minteyay/gkos_pebble/README.md

# wireless GKOS chording keyboard + mouse with BLE

based on the GKOS chording standard (http://gkos.com/gkos/gkos-charset.html) with a few modifications for computer-centric usage.
