minteyay/gkos_pebble/gkos_pebble_BOM.xlsx

Reference | Value | Footprint | Qty | €/unit | subtot. | source
BAT1,BAT2 | Keystone 55 | Keystone 55 | 2 | 0.370 | 0.740 | https://www.digikey.fi/en/products/detail/keystone-electronics/55/316403
C2-C5 | 10uF | 0603 | 4 |  | 0.000
C6,C7 | 15pF | 0402 | 2 |  | 0.000
C8,C23 | 100nF | 0603 | 2 |  | 0.000
C9,C10,C12,C14-C20 | 100nF | 0402 | 10 |  | 0.000
C11,C13 | 1uF | 0402 | 2 |  | 0.000
C21,C22 | 12pF | 0603 | 2 |  | 0.000
C24 | 4.7uF | 0603 | 1 |  | 0.000
C25-C34,C39 | 0.1uF | 0603 | 11 |  | 0.000
C35-C38 | 1uF | 0603 | 4 |  | 0.000
D1 | UDT14A05L03 | SOT-143 | 1 | 0.330 | 0.330 | https://www.digikey.fi/en/products/detail/yageo/UDT14A05L03/10126659
D2-D4 | LAD52C03L01 | SOD-523 | 3 | 0.196 | 0.588 | https://www.digikey.fi/en/products/detail/yageo/LAD52C03L01/15855310
D5-D8 | RB521S30 | SOD-523 | 4 | 0.102 | 0.408 | https://www.digikey.fi/en/products/detail/onsemi/RB521S30T1G/964627
D9 | IN-S63AT5A | 0603 LED | 1 | 0.163 | 0.163 | https://www.digikey.fi/en/products/detail/inolux/IN-S63AT5A/7604928
F1 | 0ZCJ0005FF2E | 1206 | 1 | 0.142 | 0.142 | https://www.digikey.fi/en/products/detail/bel-fuse-inc/0ZCJ0005FF2E/4156127
IC1 | RT8096AHGJ5 | SOT-23-5 | 1 | 0.370 | 0.370 | https://www.digikey.fi/en/products/detail/richtek-usa-inc/RT8096AHGJ5/5820077
IC2 | TLV61070A | SOT-23-6 | 1 | 0.450 | 0.450 | https://www.digikey.fi/en/products/detail/texas-instruments/TLV61070ADBVR/16982069
IC3 | W25Q64JVZPIQ | WSON-8 | 1 | 1.020 | 1.020 | https://www.digikey.fi/en/products/detail/winbond-electronics/W25Q64JVZPIQ/15181953
IC4 | RP2040 | QFN-56 | 1 | 0.650 | 0.650 | https://www.digikey.fi/en/products/detail/raspberry-pi/SC0914-13/14306010
IC5 | AT24C01D-STUM-T | SOT-23-5 | 1 | 0.150 | 0.150 | https://www.digikey.fi/en/products/detail/microchip-technology/AT24C01D-STUM-T/4914368
J1 | 20021121-00006T4LF | hdr 2x03 P1.27mm vert | 1 | 0.560 | 0.560 | https://www.digikey.fi/en/products/detail/amphenol-cs-fci/20021121-00006T4LF/4243603
J2 | 217183-0001 | 217183-0001 | 1 | 1.150 | 1.150 | https://www.digikey.fi/en/products/detail/molex/2171830001/13913751?s=N4IgTCBcDa4IwHY4A4DMBaADNuIC6AvkA
J3 | BM03B-SRSS-TB | JST SH BM03B-SRSS-TB | 1 | 0.490 | 0.490 | https://www.digikey.fi/en/products/detail/jst-sales-america-inc/BM03B-SRSS-TB/926695
J4 | TPS43 (connection) | bare wires to MOD2 | 1 | 0.000 | 0.000
J5 | F3311A7H121010E200 | F3311A7H121010E200 | 1 | 0.420 | 0.420 | https://www.digikey.fi/en/products/detail/amphenol-cs-fci/F3311A7H121010E200/15287509
L1 | 1.5uH | 1008 | 1 | 0.260 | 0.260 | https://www.digikey.fi/en/products/detail/murata-electronics/DFE252012P-1R5M-P2/5247259
L2 | 2.2uH | EXL1V0402-2R2-R | 1 | 0.680 | 0.680 | https://www.digikey.fi/en/products/detail/eaton-electronics-division/EXL1V0402-2R2-R/13912348
LCD1 | LS013B7DH03 | LS013B7DH03 | 1 | 11.000 | 11.000 | https://www.digikey.fi/en/products/detail/sharp-microelectronics/LS013B7DH03/5300387
MOD1 | BT832A | BT832A | 1 | 6.510 | 6.510 | https://www.digikey.fi/en/products/detail/fanstel-corp/BT832A/8323654
MOD2 | TPS43-201A-S | TPS43 | 1 | 4.280 | 4.280 | https://www.digikey.fi/en/products/detail/azoteq-pty-ltd/TPS43-201A-S/7164940
Q1 | SSM3J35AMFV | SOT-723 | 1 | 0.220 | 0.220 | https://www.digikey.fi/en/products/detail/toshiba-semiconductor-and-storage/SSM3J35AMFV-L3F/8543433
R1,R2 | 5.1k | 0603 | 2 |  | 0.000
R3,R5 | 100k 1% | 0603 | 2 |  | 0.000
R4 | 22k 1% | 0603 | 1 |  | 0.000
R6 | 18k 1% | 0603 | 1 |  | 0.000
R7 | 1k | 0603 | 1 |  | 0.000
R9 | 1k | 0402 | 1 |  | 0.000
R10,R11 | 27.4 | 0402 | 2 |  | 0.000
R12,R13 | 100R | 0402 | 2 |  | 0.000
R14,R15 | 10k | 0402 | 2 |  | 0.000
R16 | 560R | 0603 | 1 |  | 0.000
R17-R22,R29-R32,R37-R39 | 100k | 0603 | 13 |  | 0.000
R23-R28,R33-R36,R40-R42 | 10k | 0603 | 13 |  | 0.000
SW1-SW6 | D2LS-21 | D2LS | 6 | 1.578 | 9.468 | https://www.digikey.fi/en/products/detail/omron-electronics-inc-emc-div/D2LS-21/5031942
SW7-SW10 | EVQ-Q2H03W | EVQ-Q2H03W | 4 | 0.235 | 0.940 | https://www.digikey.fi/en/products/detail/panasonic-electronic-components/EVQ-Q2H03W/762890
SW11-SW13 | RKB2SJM250SMTR | RKB2SJM250SMTRLFS | 3 | 0.180 | 0.540 | https://www.digikey.fi/en/products/detail/c-k/RKB2SJM250SMTR-LFS/13997207
Y1 | RH100-12.000-12-1010-X-TR-NS2 | RH100 | 1 | 0.170 | 0.170 | https://www.digikey.fi/en/products/detail/raltron-electronics/RH100-12-000-12-1010-X-TR-NS2/15963328
Y2 | FC-135 32.7680KA-AC0 | 3215 XTAL | 1 | 0.560 | 0.560 | https://www.digikey.fi/en/products/detail/epson/FC-135-32-7680KA-AC0/2834057
 |  | subtotal excl. VAT |  |  | 42.259
 |  | total incl. 24% VAT |  |  | 52.401
