minteyay/gkos_pebble/gkos_pebble.kicad_pcb

## KiCad design gkos_pebble.kicad_pcb (2024-04-06)

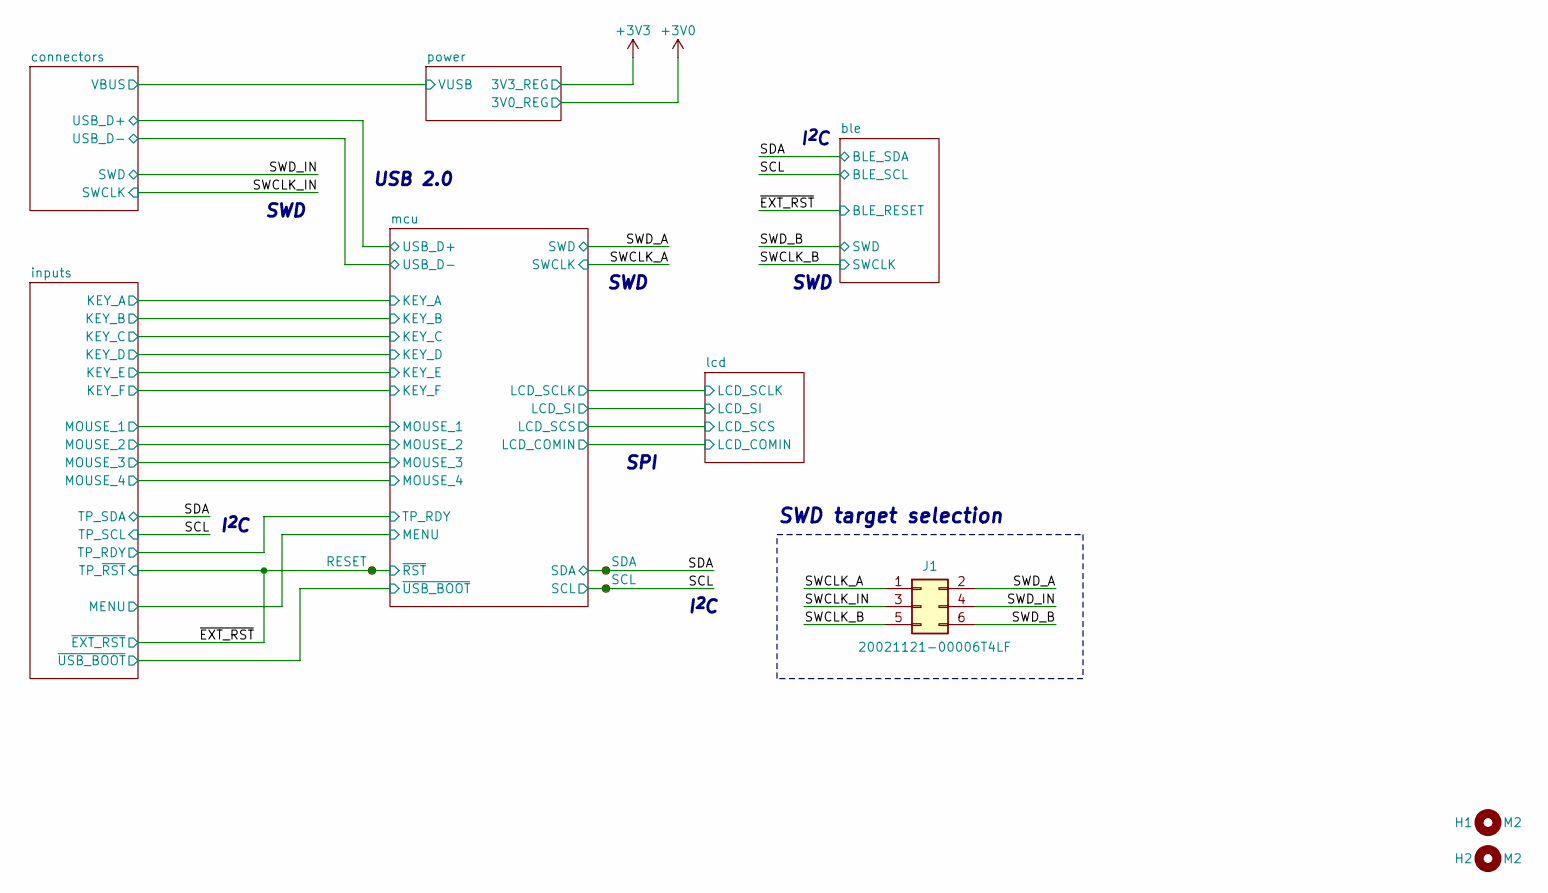
[picture p8: schematic gkos_pebble.kicad_sch, gkos pebble]

Parts:
H1, H2: M2; MountingHole_2.2mm_M2
J1: 20021121-00006T4LF; PinHeader_2x03_P1.27mm_Vertical_SMD
TP1: RESET; TestPoint_Pad_D1.0mm
TP2: SDA; TestPoint_Pad_D1.0mm
TP3: SCL; TestPoint_Pad_D1.0mm

Connections:
/SCL: TP3.1; also elsewhere on the board
/SDA: TP2.1; also elsewhere on the board
/SWCLK_A: J1.1; also elsewhere on the board
/SWCLK_B: J1.5; also elsewhere on the board
/SWCLK_IN: J1.3; also elsewhere on the board
/SWD_A: J1.2; also elsewhere on the board
/SWD_B: J1.6; also elsewhere on the board
/SWD_IN: J1.4; also elsewhere on the board
/~EXT_RST: TP1.1; also elsewhere on the board

Notes on the sheet:
SWD
I^{2}C
SPI
USB 2.0
SWD target selection

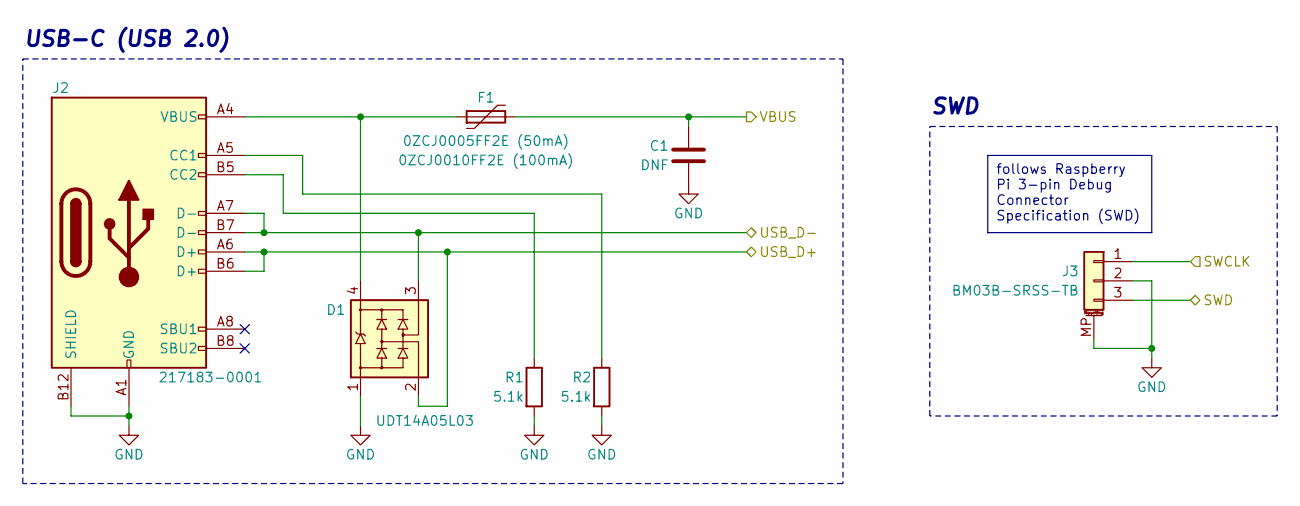
[picture p9: schematic connectors.kicad_sch, gkos pebble]

Parts:
C1: DNF; C_0603_1608Metric
D1: UDT14A05L03; SOT-143_Handsoldering
F1: 0ZCJ0005FF2E (50mA); R_1206_3216Metric
J2: 217183-0001; 2171830001
J3: BM03B-SRSS-TB; JST_SH_BM03B-SRSS-TB_1x03-1MP_P1.00mm_Vertical
R1, R2: 5.1k; R_0603_1608Metric

Connections:
/SWCLK_IN: J3.1; also elsewhere on the board
/SWD_IN: J3.3; also elsewhere on the board
/connectors/VBUS: C1.1, F1.2; also elsewhere on the board
/mcu/USB_D+: D1.2, J2.A6 (D+), J2.B6 (D+); also elsewhere on the board
/mcu/USB_D-: D1.3, J2.A7 (D-), J2.B7 (D-); also elsewhere on the board
GND: C1.2, D1.1, J2.A1 (GND), J2.A12 (GND), J2.B1 (GND), J2.B12 (GND), J3.2, J3.MP (MountPin), R1.2, R2.2; also elsewhere on the board
unnamed: D1.4, F1.1, J2.A4 (VBUS), J2.A9 (VBUS), J2.B4 (VBUS), J2.B9 (VBUS)
unnamed: J2.A5 (CC1), R2.1
unnamed: J2.B5 (CC2), R1.1

Notes on the sheet:
follows Raspberry Pi 3-pin Debug Connector Specification (SWD)
SWD
USB-C (USB 2.0)

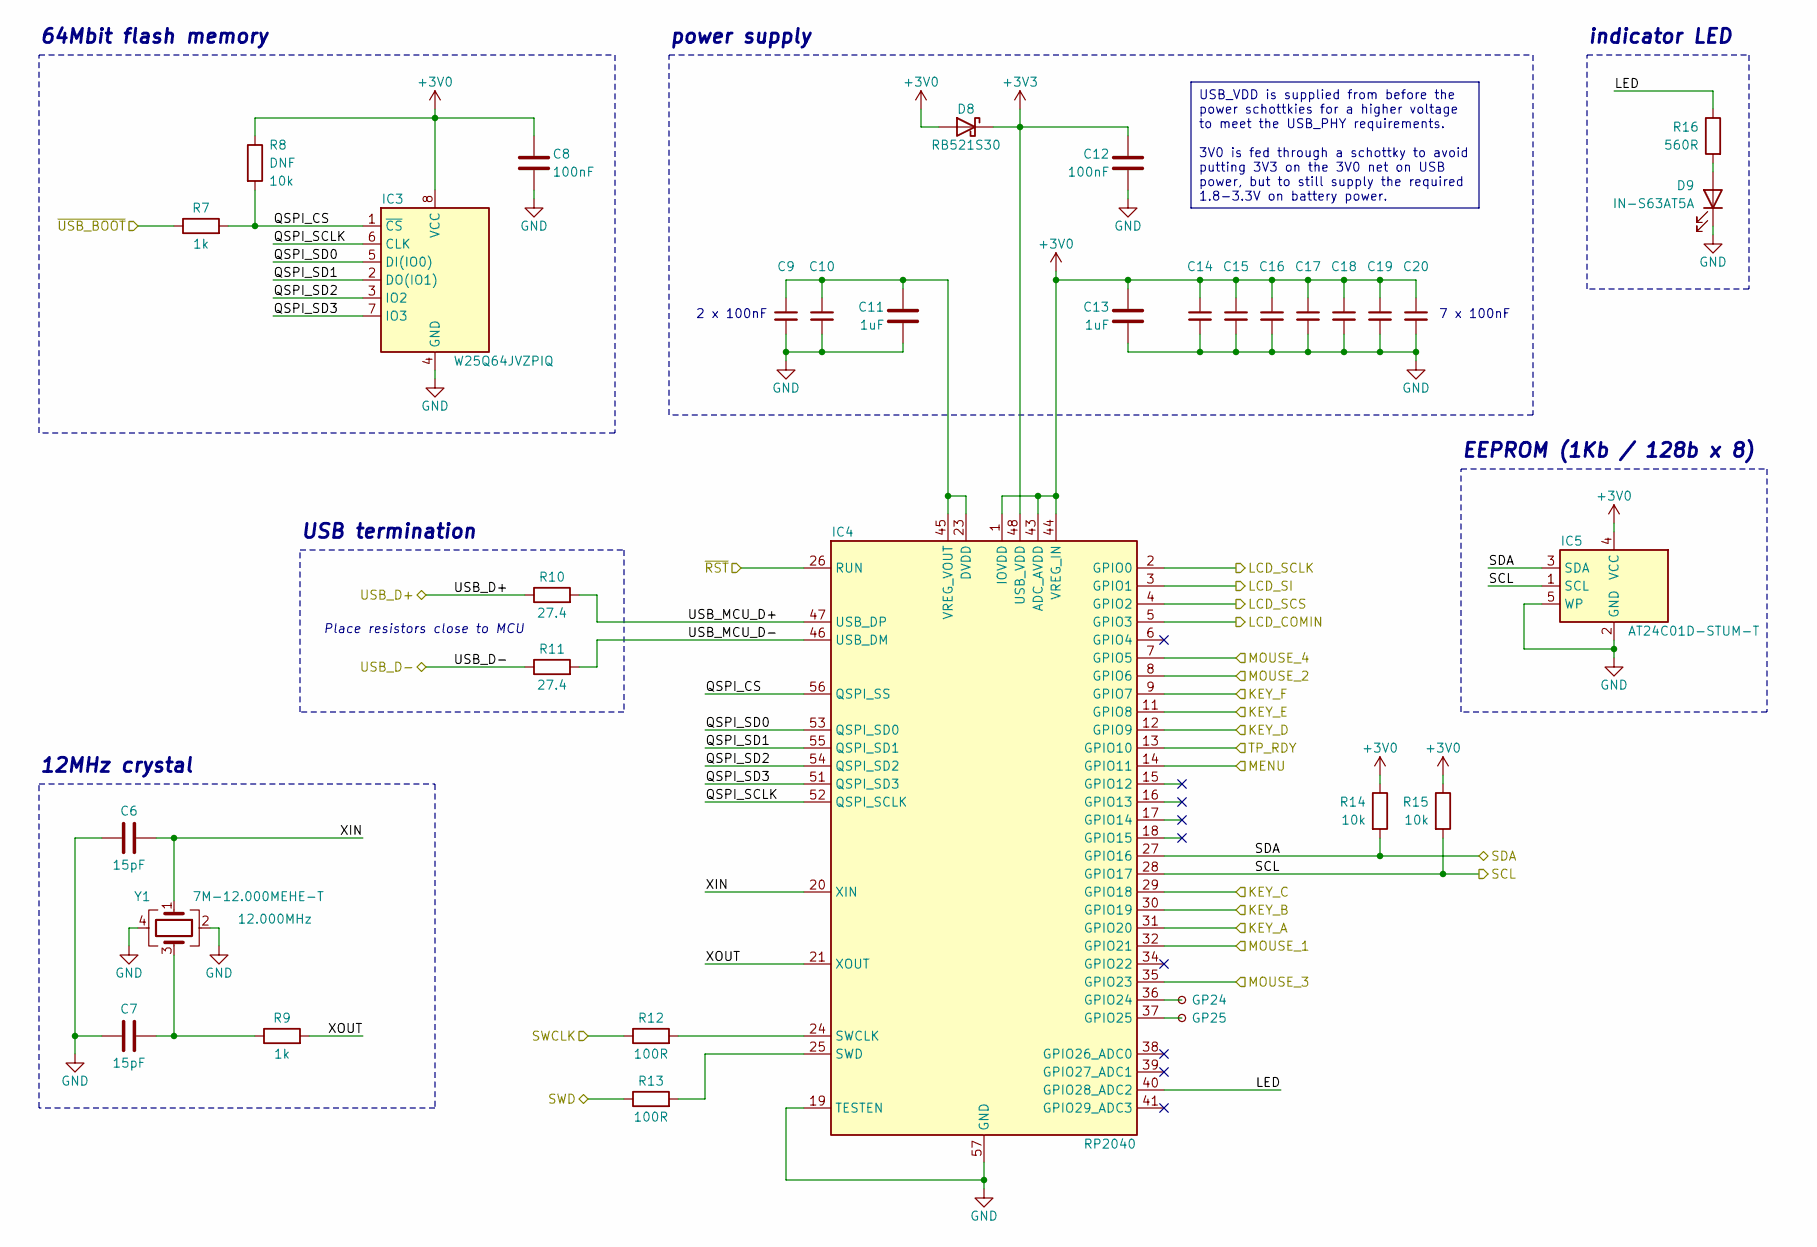
[picture p10: schematic mcu.kicad_sch, gkos pebble]

Parts:
C6, C7: 15pF; C_0402_1005Metric
C8: 100nF; C_0603_1608Metric
C9, C10, C12, C14, C15, C16, C17, C18, C19, C20: 100nF; C_0402_1005Metric
C11, C13: 1uF; C_0402_1005Metric
D8: RB521S30; D_SOD-523
D9: IN-S63AT5A; LED_0603_1608Metric
IC3: W25Q64JVZPIQ; WSON-8-1EP_6x5mm_P1.27mm_EP3.4x4.3mm
IC4: RP2040; QFN-56-1EP_7x7mm_P0.4mm_EP3.2x3.2mm
IC5: AT24C01D-STUM-T; SOT-23-5
R7: 1k; R_0603_1608Metric
R8: DNF; R_0603_1608Metric
R9: 1k; R_0402_1005Metric
R10, R11: 27.4; R_0402_1005Metric
R12, R13: 100R; R_0402_1005Metric
R14, R15: 10k; R_0402_1005Metric
R16: 560R; R_0603_1608Metric
TP4: GP24; TestPoint_Pad_D1.0mm
TP5: GP25; TestPoint_Pad_D1.0mm
Y1: 7M-12.000MEHE-T

Connections:
+3V0: C8.1, C13.1, C14.1, C15.1, C16.1, C17.1, C18.1, C19.1, C20.1, D8.2 (A), IC3.8 (VCC), IC4.1 (IOVDD), IC4.10 (IOVDD), IC4.22 (IOVDD), IC4.33 (IOVDD), IC4.42 (IOVDD), IC4.43 (ADC_AVDD), IC4.44 (VREG_IN), IC4.49 (IOVDD), IC5.4 (VCC), R8.1, R14.1, R15.1; also elsewhere on the board
+3V3: C12.1, D8.1 (K), IC4.48 (USB_VDD); also elsewhere on the board
/SCL: IC4.28 (GPIO17), IC5.1 (SCL), R15.2; also elsewhere on the board
/SDA: IC4.27 (GPIO16), IC5.3 (SDA), R14.2; also elsewhere on the board
/SWCLK_A: R12.1; also elsewhere on the board
/SWD_A: R13.1; also elsewhere on the board
/inputs/KEY_A: IC4.31 (GPIO20); also elsewhere on the board
/inputs/KEY_B: IC4.30 (GPIO19); also elsewhere on the board
/inputs/KEY_C: IC4.29 (GPIO18); also elsewhere on the board
/inputs/KEY_D: IC4.12 (GPIO9); also elsewhere on the board
/inputs/KEY_E: IC4.11 (GPIO8); also elsewhere on the board
/inputs/KEY_F: IC4.9 (GPIO7); also elsewhere on the board
/inputs/MENU: IC4.14 (GPIO11); also elsewhere on the board
/inputs/MOUSE_1: IC4.32 (GPIO21); also elsewhere on the board
/inputs/MOUSE_2: IC4.8 (GPIO6); also elsewhere on the board
/inputs/MOUSE_3: IC4.35 (GPIO23); also elsewhere on the board
/inputs/MOUSE_4: IC4.7 (GPIO5); also elsewhere on the board
/inputs/TP_RDY: IC4.13 (GPIO10); also elsewhere on the board
/inputs/~USB_BOOT: R7.1; also elsewhere on the board
/lcd/LCD_COMIN: IC4.5 (GPIO3); also elsewhere on the board
/lcd/LCD_SCLK: IC4.2 (GPIO0); also elsewhere on the board
/lcd/LCD_SCS: IC4.4 (GPIO2); also elsewhere on the board
/lcd/LCD_SI: IC4.3 (GPIO1); also elsewhere on the board
/mcu/LED: IC4.40 (GPIO28_ADC2), R16.1
/mcu/QSPI_CS: IC3.1 (~CS), IC4.56 (QSPI_SS), R7.2, R8.2
/mcu/QSPI_SCLK: IC3.6 (CLK), IC4.52 (QSPI_SCLK)
/mcu/QSPI_SD0: IC3.5 (DI(IO0)), IC4.53 (QSPI_SD0)
/mcu/QSPI_SD1: IC3.2 (DO(IO1)), IC4.55 (QSPI_SD1)
/mcu/QSPI_SD2: IC3.3 (IO2), IC4.54 (QSPI_SD2)
/mcu/QSPI_SD3: IC3.7 (IO3), IC4.51 (QSPI_SD3)
/mcu/USB_D+: R10.1; also elsewhere on the board
/mcu/USB_D-: R11.1; also elsewhere on the board
/mcu/USB_MCU_D+: IC4.47 (USB_DP), R10.2
/mcu/USB_MCU_D-: IC4.46 (USB_DM), R11.2
/mcu/XIN: C6.2, IC4.20 (XIN), Y1.1
/mcu/XOUT: IC4.21 (XOUT), R9.2
/~EXT_RST: IC4.26 (RUN); also elsewhere on the board
GND: C6.1, C7.1, C8.2, C9.2, C10.2, C11.2, C12.2, C13.2, C14.2, C15.2, C16.2, C17.2, C18.2, C19.2, C20.2, D9.1 (K), IC3.4 (GND), IC4.19 (TESTEN), IC4.57 (GND), IC5.2 (GND), IC5.5 (WP), Y1.2, Y1.4; also elsewhere on the board
unnamed: C7.2, R9.1, Y1.3
unnamed: D9.2 (A), R16.2
unnamed: IC4.36 (GPIO24), TP4.1
unnamed: IC4.37 (GPIO25), TP5.1
unnamed: IC4.24 (SWCLK), R12.2
unnamed: IC4.25 (SWD), R13.2
unnamed: C9.1, C10.1, C11.1, IC4.23 (DVDD), IC4.45 (VREG_VOUT), IC4.50 (DVDD)

Notes on the sheet:
USB_VDD is supplied from before the power schottkies for a higher voltage to meet the USB_PHY requirements. 3V0 is fed through a schottky to avoid putting 3V3 on the 3V0 net on USB power, but to still supply the required 1.8-3.3V on battery power.
Place resistors close to MCU
7 x 100nF
2 x 100nF
EEPROM (1Kb / 128b x 8)
indicator LED
USB termination
64Mbit flash memory
12MHz crystal
power supply

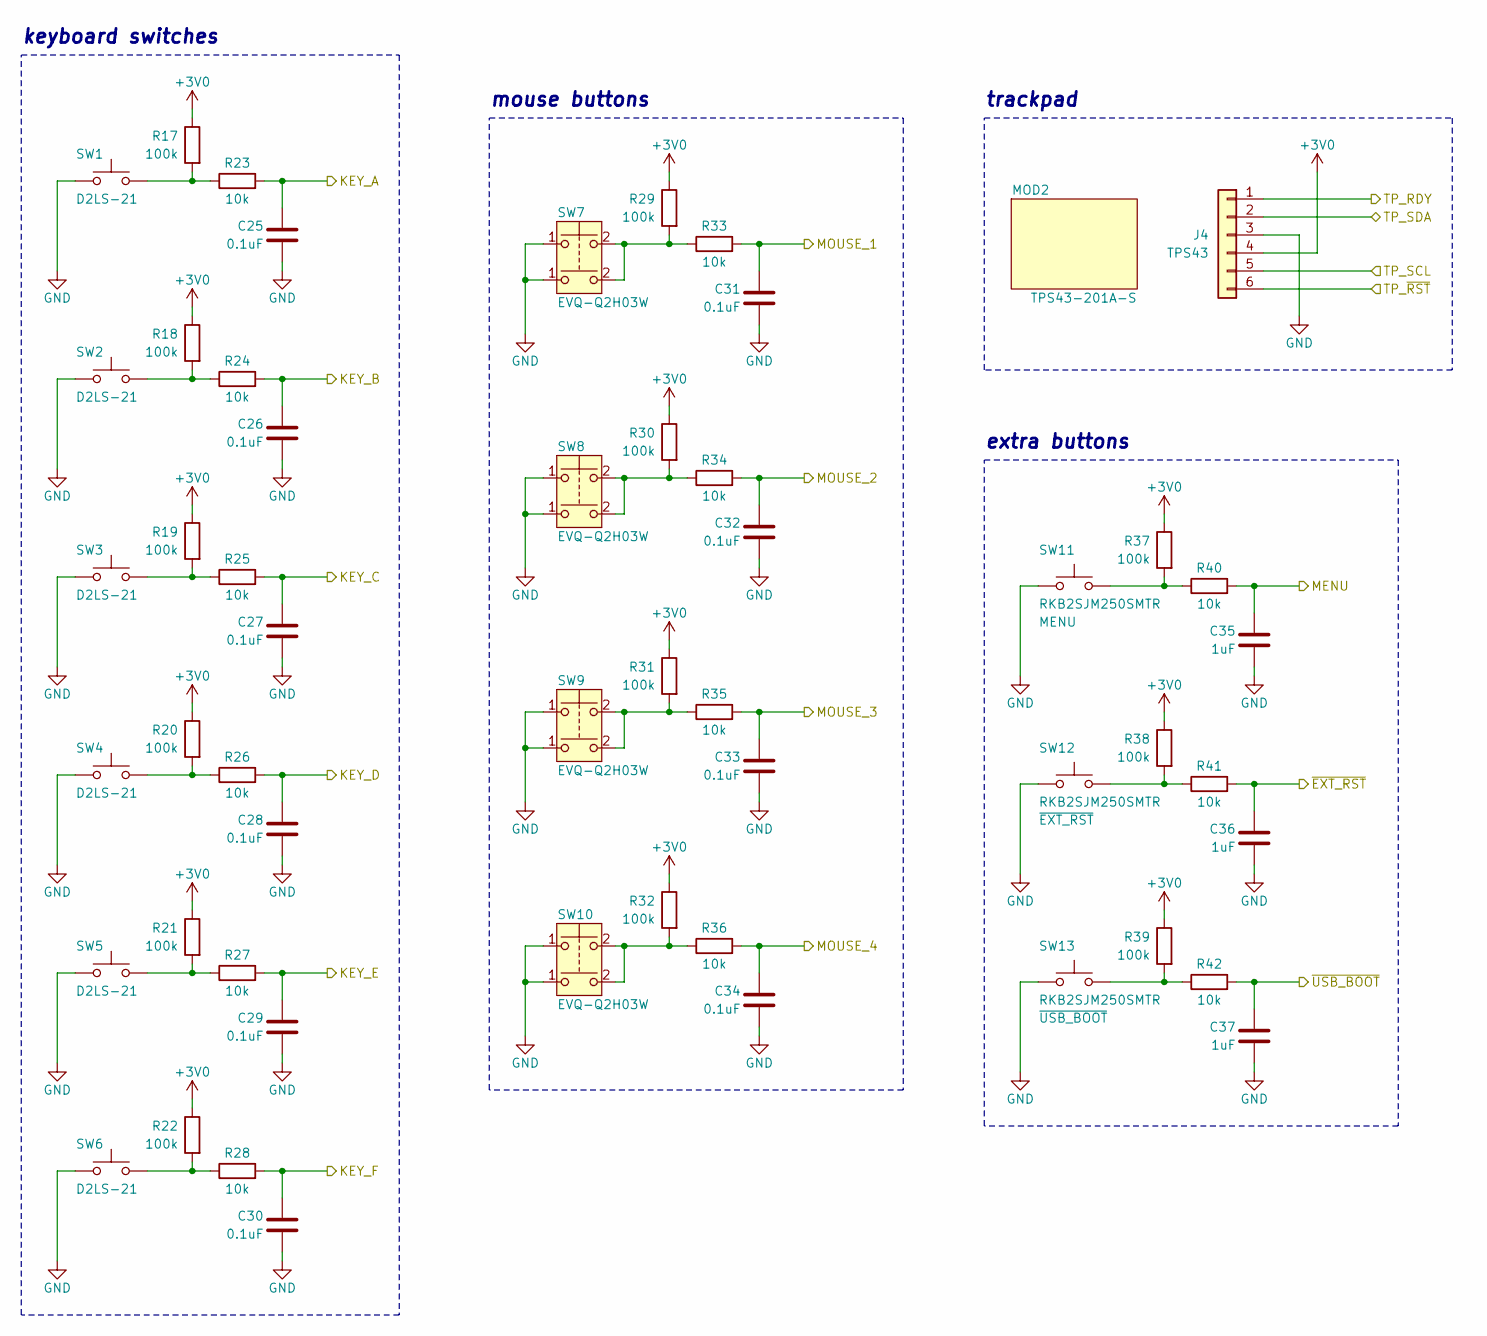
[picture p11: schematic inputs.kicad_sch, gkos pebble]

Parts:
C25, C26, C27, C28, C29, C30, C31, C32, C33, C34: 0.1uF; C_0603_1608Metric
C35, C36, C37: 1uF; C_0603_1608Metric
J4: TPS43; TPS43_wires
MOD2: TPS43-201A-S; TPS43
R17, R18, R19, R20, R21, R22, R29, R30, R31, R32, R37, R38, R39: 100k; R_0603_1608Metric
R23, R24, R25, R26, R27, R28, R33, R34, R35, R36, R40, R41, R42: 10k; R_0603_1608Metric
SW1, SW2, SW3, SW4, SW5, SW6: D2LS-21; D2LS
SW7, SW8, SW9, SW10: EVQ-Q2H03W
SW11, SW12, SW13: RKB2SJM250SMTR; RKB2SJM250SMTRLFS

Connections:
+3V0: J4.4, R17.1, R18.1, R19.1, R20.1, R21.1, R22.1, R29.1, R30.1, R31.1, R32.1, R37.1, R38.1, R39.1; also elsewhere on the board
/SCL: J4.5; also elsewhere on the board
/SDA: J4.2; also elsewhere on the board
/inputs/KEY_A: C25.1, R23.2; also elsewhere on the board
/inputs/KEY_B: C26.1, R24.2; also elsewhere on the board
/inputs/KEY_C: C27.1, R25.2; also elsewhere on the board
/inputs/KEY_D: C28.1, R26.2; also elsewhere on the board
/inputs/KEY_E: C29.1, R27.2; also elsewhere on the board
/inputs/KEY_F: C30.1, R28.2; also elsewhere on the board
/inputs/MENU: C35.1, R40.2; also elsewhere on the board
/inputs/MOUSE_1: C31.1, R33.2; also elsewhere on the board
/inputs/MOUSE_2: C32.1, R34.2; also elsewhere on the board
/inputs/MOUSE_3: C33.1, R35.2; also elsewhere on the board
/inputs/MOUSE_4: C34.1, R36.2; also elsewhere on the board
/inputs/TP_RDY: J4.1; also elsewhere on the board
/inputs/~USB_BOOT: C37.1, R42.2; also elsewhere on the board
/~EXT_RST: C36.1, J4.6, R41.2; also elsewhere on the board
GND: C25.2, C26.2, C27.2, C28.2, C29.2, C30.2, C31.2, C32.2, C33.2, C34.2, C35.2, C36.2, C37.2, J4.3, SW1.1, SW2.1, SW3.1, SW4.1, SW5.1, SW6.1, SW7.1 (1b), SW8.1 (1b), SW9.1 (1a), SW10.1 (1a), SW11.1, SW12.1, SW13.1; also elsewhere on the board
unnamed: R17.2, R23.1, SW1.2
unnamed: R18.2, R24.1, SW2.2
unnamed: R19.2, R25.1, SW3.2
unnamed: R20.2, R26.1, SW4.2
unnamed: R21.2, R27.1, SW5.2
unnamed: R22.2, R28.1, SW6.2
unnamed: R37.2, R40.1, SW11.2
unnamed: R38.2, R41.1, SW12.2
unnamed: R39.2, R42.1, SW13.2
unnamed: R29.2, R33.1, SW7.2 (2a)
unnamed: R30.2, R34.1, SW8.2 (2a)
unnamed: R31.2, R35.1, SW9.2 (2a)
unnamed: R32.2, R36.1, SW10.2 (2a)

Notes on the sheet:
mouse buttons
trackpad
extra buttons
keyboard switches

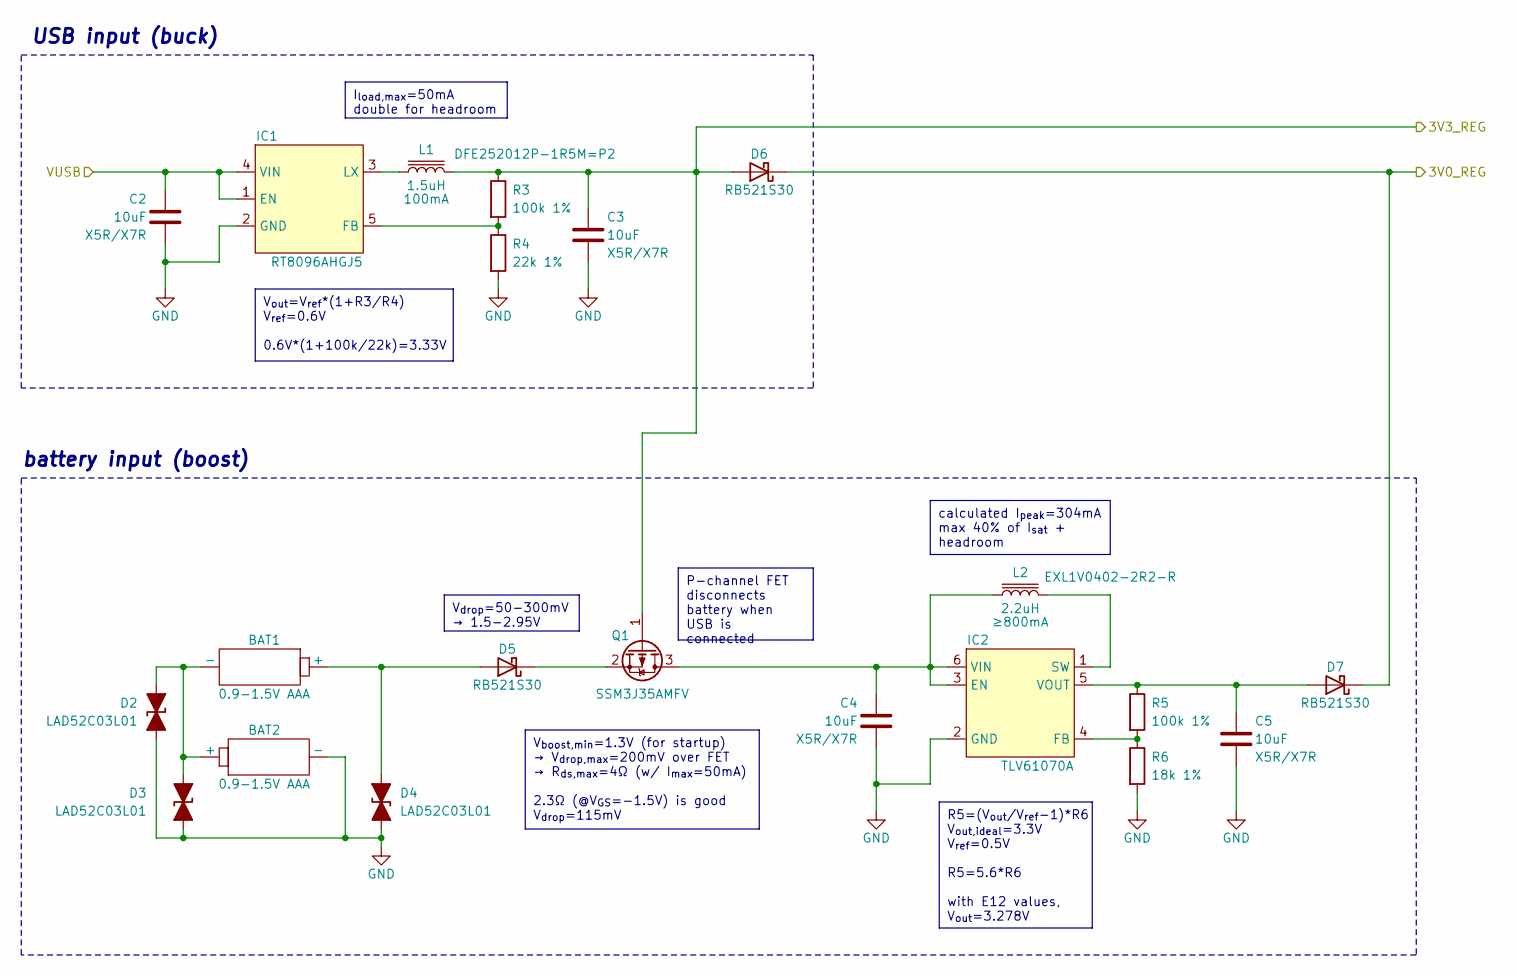
[picture p12: schematic power.kicad_sch, gkos pebble]

Parts:
BAT1, BAT2: 0.9-1.5V AAA; Keystone_55_1xAAA
C2, C3, C4, C5: 10uF; C_0603_1608Metric
D2, D3, D4: LAD52C03L01; D_SOD-523
D5, D6, D7: RB521S30; D_SOD-523
IC1: RT8096AHGJ5; SOT-23-5
IC2: TLV61070A; SOT-23-6
L1: 1.5uH; L_1008_2520Metric
L2: 2.2uH; EXL1V0402-2R2-R
Q1: SSM3J35AMFV; SOT-723
R3, R5: 100k 1%; R_0603_1608Metric
R4: 22k 1%; R_0603_1608Metric
R6: 18k 1%; R_0603_1608Metric

Connections:
+3V0: D6.1 (K), D7.1 (K); also elsewhere on the board
+3V3: C3.1, D6.2 (A), L1.2, Q1.1 (G), R3.1; also elsewhere on the board
/connectors/VBUS: C2.1, IC1.1 (EN), IC1.4 (VIN); also elsewhere on the board
GND: BAT2.2 (-), C2.2, C3.2, C4.2, C5.2, D2.1 (A1), D3.1 (A1), D4.1 (A1), IC1.2 (GND), IC2.2 (GND), R4.2, R6.2; also elsewhere on the board
unnamed: BAT1.1 (+), D4.2 (A2), D5.2 (A)
unnamed: BAT1.2 (-), BAT2.1 (+), D2.2 (A2), D3.2 (A2)
unnamed: D5.1 (K), Q1.2 (S)
unnamed: C5.1, D7.2 (A), IC2.5 (VOUT), R5.1
unnamed: IC1.5 (FB), R3.2, R4.1
unnamed: IC1.3 (LX), L1.1
unnamed: C4.1, IC2.3 (EN), IC2.6 (VIN), L2.1, Q1.3 (D)
unnamed: IC2.4 (FB), R5.2, R6.1
unnamed: IC2.1 (SW), L2.2

Notes on the sheet:
I_{load,max}=50mA double for headroom
P-channel FET disconnects battery when USB is connected
R5=(V_{out}/V_{ref}-1)*R6 V_{out,ideal}=3.3V V_{ref}=0.5V R5=5.6*R6 with E12 values, V_{out}=3.278V
V_{out}=V_{ref}*(1+R3/R4) V_{ref}=0.6V 0.6V*(1+100k/22k)=3.33V
V_{boost,min}=1.3V (for startup) → V_{drop,max}=200mV over FET → R_{ds,max}=4Ω (w/ I_{max}=50mA) 2.3Ω (@V_{GS}=-1.5V) is good V_{drop}=115mV
calculated I_{peak}=304mA max 40% of I_{sat} + headroom
V_{drop}=50-300mV → 1.5-2.95V
USB input (buck)
battery input (boost)

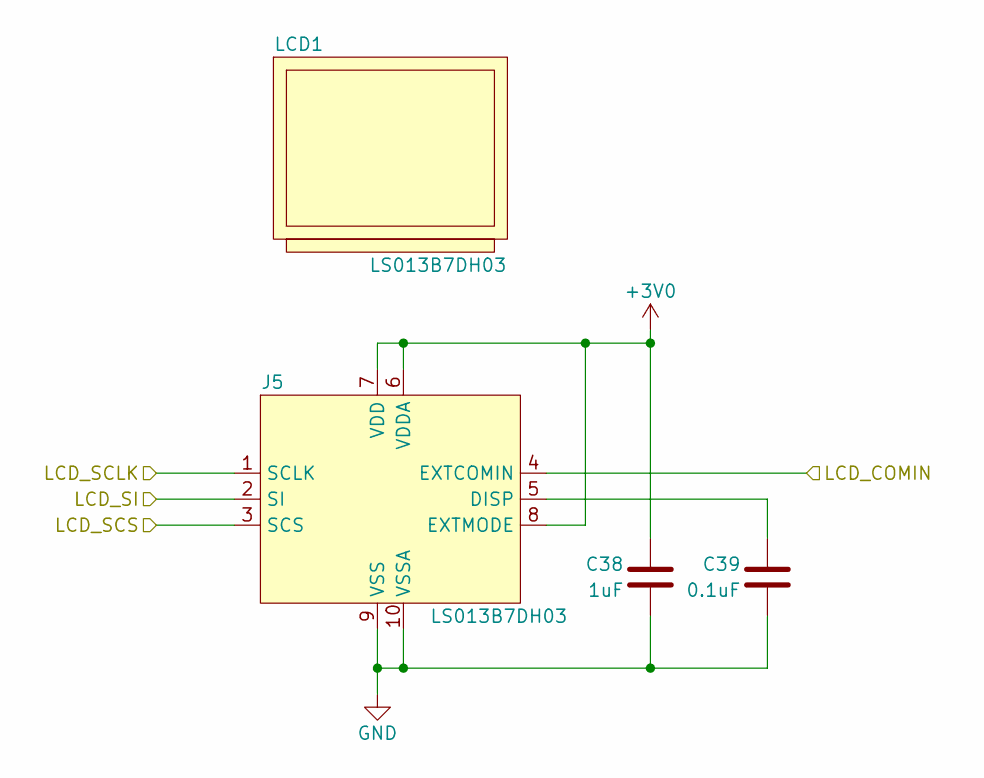
[picture p13: schematic lcd.kicad_sch, gkos pebble]

Parts:
C38: 1uF; C_0603_1608Metric
C39: 0.1uF; C_0603_1608Metric
J5: LS013B7DH03; F3311A7H121010E200
LCD1: LS013B7DH03

Connections:
+3V0: C38.1, J5.6 (VDDA), J5.7 (VDD), J5.8 (EXTMODE); also elsewhere on the board
/lcd/LCD_COMIN: J5.4 (EXTCOMIN); also elsewhere on the board
/lcd/LCD_SCLK: J5.1 (SCLK); also elsewhere on the board
/lcd/LCD_SCS: J5.3 (SCS); also elsewhere on the board
/lcd/LCD_SI: J5.2 (SI); also elsewhere on the board
GND: C38.2, C39.2, J5.9 (VSS), J5.10 (VSSA); also elsewhere on the board
unnamed: C39.1, J5.5 (DISP)

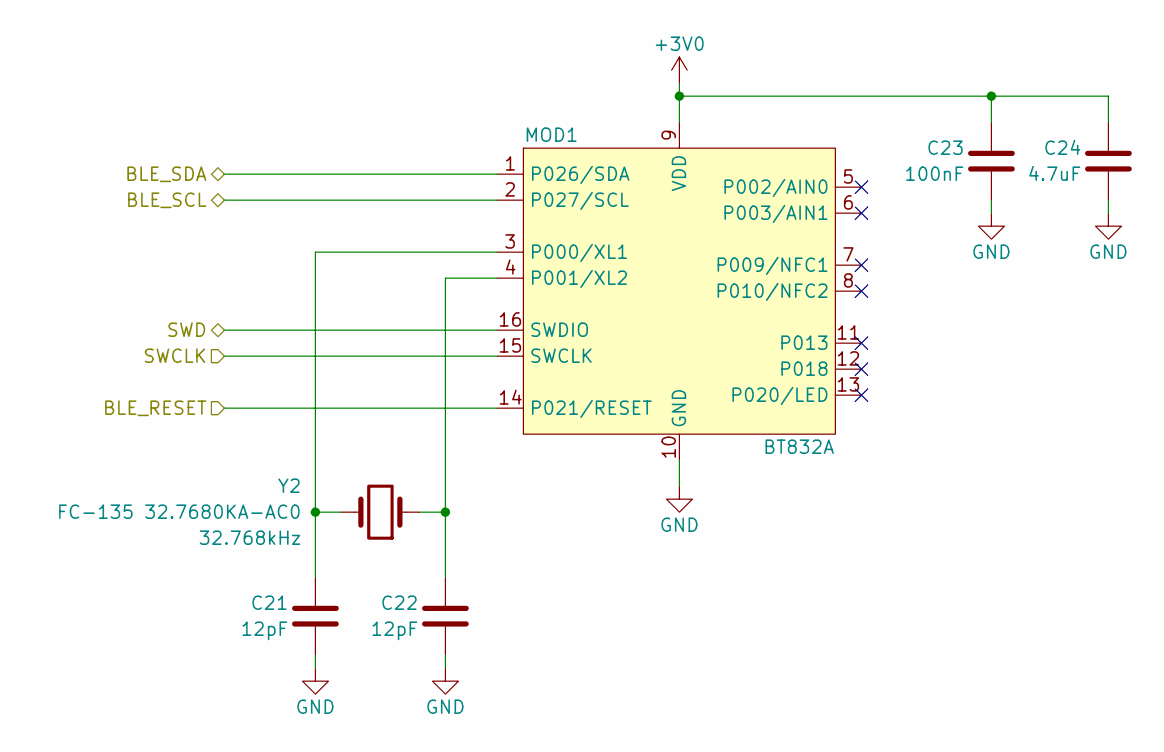
[picture p14: schematic ble.kicad_sch, gkos pebble]

Parts:
C21, C22: 12pF; C_0603_1608Metric
C23: 100nF; C_0603_1608Metric
C24: 4.7uF; C_0603_1608Metric
MOD1: BT832A
Y2: FC-135 32.7680KA-AC0; Crystal_SMD_3215-2Pin_3.2x1.5mm

Connections:
+3V0: C23.1, C24.1, MOD1.9 (VDD); also elsewhere on the board
/SCL: MOD1.2 (P027/SCL); also elsewhere on the board
/SDA: MOD1.1 (P026/SDA); also elsewhere on the board
/SWCLK_B: MOD1.15 (SWCLK); also elsewhere on the board
/SWD_B: MOD1.16 (SWDIO); also elsewhere on the board
/~EXT_RST: MOD1.14 (P021/RESET); also elsewhere on the board
GND: C21.1, C22.1, C23.2, C24.2, MOD1.10 (GND); also elsewhere on the board
unnamed: C21.2, MOD1.3 (P000/XL1), Y2.2
unnamed: C22.2, MOD1.4 (P001/XL2), Y2.1

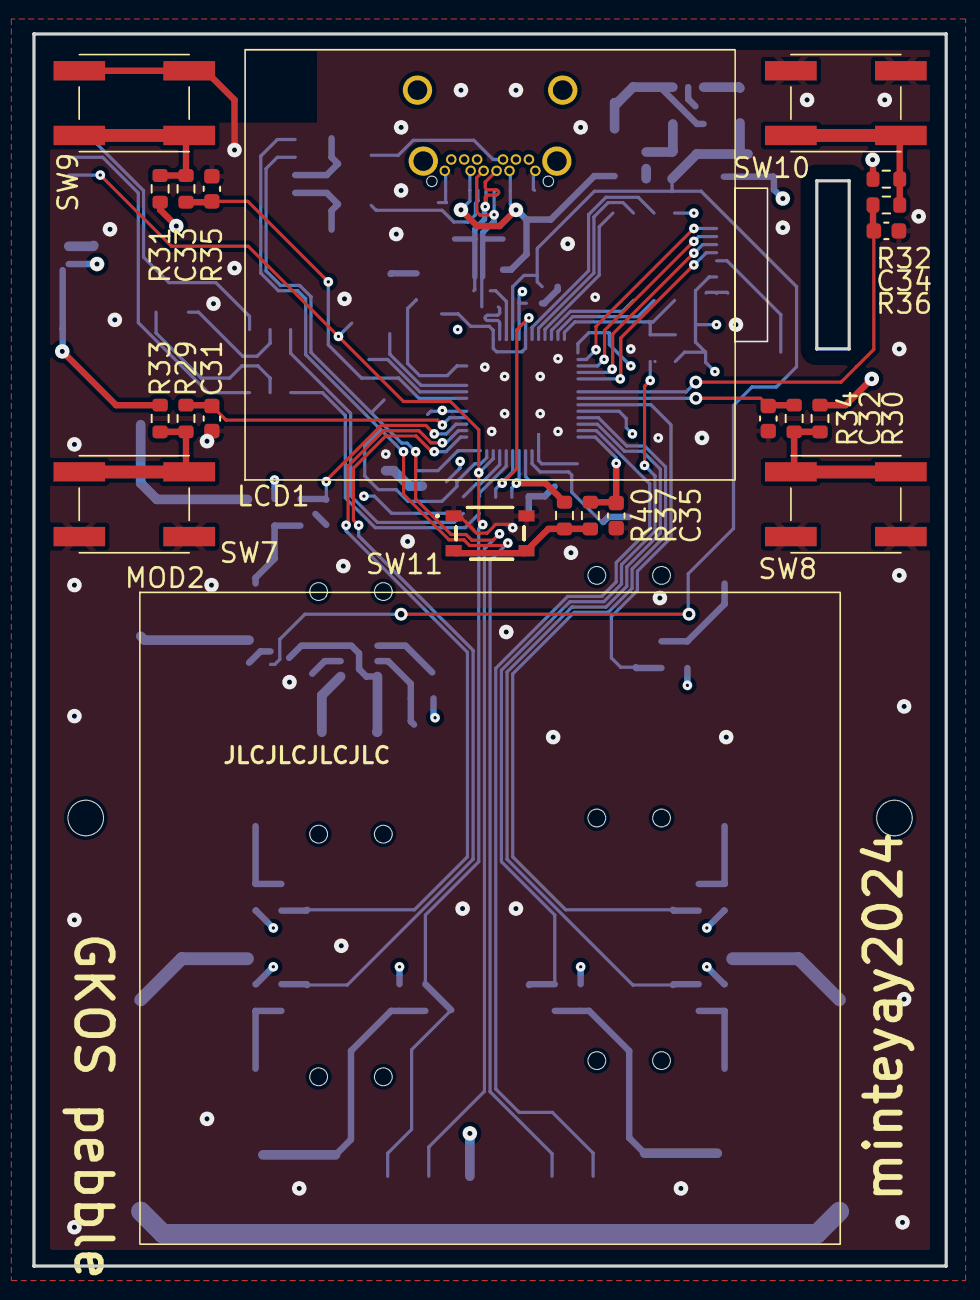
[picture p15: board gkos_pebble.kicad_pcb from above]

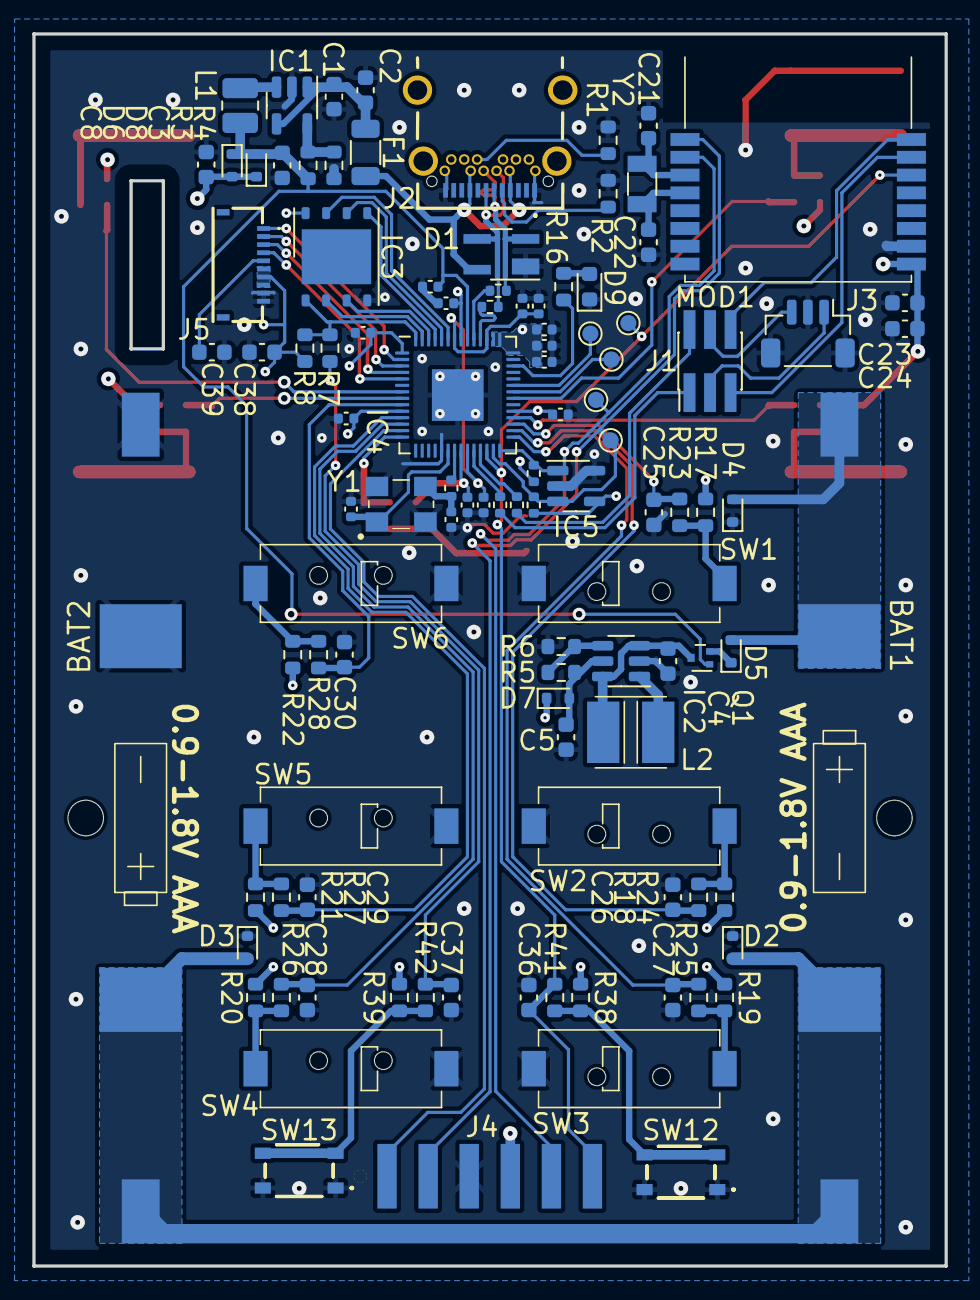
[picture p16: board gkos_pebble.kicad_pcb from below]

Board: 4 copper layers, 56.4 x 76.2 mm, 131 parts (107 on the bottom side), 78 nets.
