minteyay/gkos_pebble/gkos_firmware/include/Pins.h

#pragma once
#include <Arduino.h>

namespace Pins {
    const pin_size_t KEY_A = 20;
    const pin_size_t KEY_B = 19;
    const pin_size_t KEY_C = 18;
    const pin_size_t KEY_D = 7;
    const pin_size_t KEY_E = 8;
    const pin_size_t KEY_F = 9;

    const pin_size_t MOUSE_1 = 21;
    const pin_size_t MOUSE_2 = 6;
    const pin_size_t MOUSE_3 = 23;
    const pin_size_t MOUSE_4 = 5;

    const pin_size_t SDA = 16;
    const pin_size_t SCL = 17;

    const pin_size_t LCD_COMIN = 0;
    const pin_size_t LCD_SCS = 1;
    const pin_size_t LCD_SCLK = 2;
    const pin_size_t LCD_SI = 3;

    const pin_size_t MENU = 11;

    const pin_size_t TP_RDY = 10;
    const pin_size_t TP_RST = 24;

    const pin_size_t LED = 25;
}
