minteyay/gkos_pebble/(commit log)

2024-02-23 power schema
    [ble.kicad_sch, gkos_pebble.kicad_sch, inputs.kicad_sch, lcd.kicad_sch, mcu.kicad_sch, power.kicad_sch]
2024-03-14 big commit with power and inputs
    [gkos_pebble.kicad_sch, inputs.kicad_sch, power.kicad_sch]
2024-03-18 power supply cleanup and overvoltage protection
    [power.kicad_sch]
2024-03-18 added power ratings to overvoltage resistors
    [power.kicad_sch]
2024-03-23 schema functionally done
    [ble.kicad_sch, connectors.kicad_sch, gkos_pebble.kicad_sch, inputs.kicad_sch, lcd.kicad_sch, mcu.kicad_sch, power.kicad_sch]
2024-03-23 change 0603 to 0805
    [connectors.kicad_sch, inputs.kicad_sch, power.kicad_sch]
2024-03-23 add external modules
    [connectors.kicad_sch, inputs.kicad_sch, lcd.kicad_sch]
2024-03-23 change usb buck resistor values
    [power.kicad_sch]
2024-03-23 add very approximate BOM
    [gkos_pebble_BOM.xlsx]
2024-03-23 update BOM
    [gkos_pebble_BOM.xlsx]
2024-03-25 schematic cleanup
    [ble.kicad_sch, connectors.kicad_sch, gkos_pebble.kicad_sch, inputs.kicad_sch, lcd.kicad_sch, mcu.kicad_sch, power.kicad_sch]
2024-03-25 cleanup cleanup
    [connectors.kicad_sch, inputs.kicad_sch, mcu.kicad_sch, power.kicad_sch]
2024-03-25 added testpoints
    [ble.kicad_sch, gkos_pebble.kicad_sch, mcu.kicad_sch, power.kicad_sch]
2024-03-25 test points
    [ble.kicad_sch, connectors.kicad_sch, gkos_pebble.kicad_sch, inputs.kicad_sch, lcd.kicad_sch, mcu.kicad_sch, power.kicad_sch]
2024-03-26 new mouse button setup
    [inputs.kicad_sch]
2024-03-26 finish new mouse button design
    [connectors.kicad_sch, gkos_pebble.kicad_sch, mcu.kicad_sch]
2024-03-26 use all smd for mouse buttons
    [inputs.kicad_sch]
2024-03-26 move to smd keyboard switches
    [inputs.kicad_sch]
2024-03-26 GPIO shuffling
    [mcu.kicad_sch]
2024-03-27 add button plunger to footprint
2024-03-27 GPIO shuffling + reannotate
    [ble.kicad_sch, mcu.kicad_sch]
2024-03-27 swap flash to smaller WSON package
    [mcu.kicad_sch]
2024-03-27 in progress pcb
    [ble.kicad_sch, connectors.kicad_sch, gkos_pebble.kicad_pcb, gkos_pebble.kicad_sch, inputs.kicad_sch, lcd.kicad_sch, mcu.kicad_sch, power.kicad_sch]
2024-03-28 schematic pdf
2024-03-29 change 2.54mm SWD header to 1.27mm
    [gkos_pebble.kicad_sch]
2024-03-30 add second battery TVS
    [mcu.kicad_sch, power.kicad_sch]
2024-03-30 add one more battery TVS
    [mcu.kicad_sch, power.kicad_sch]
2024-03-30 initial component placement on pcb
    [gkos_pebble.kicad_pcb]
2024-03-30 oops lcd had no power
    [lcd.kicad_sch]
2024-03-31 add the dang eeprom
    [ble.kicad_sch, inputs.kicad_sch, lcd.kicad_sch, mcu.kicad_sch]
2024-03-31 swap crystal for smaller one
    [mcu.kicad_sch]
2024-03-31 in-progress second layout attempt
    [gkos_pebble.kicad_pcb, gkos_pebble.kicad_sch]
2024-04-03 pcb done, also kicad 8
    [ble.kicad_sch, connectors.kicad_sch, gkos_pebble.kicad_pcb, gkos_pebble.kicad_sch, inputs.kicad_sch, lcd.kicad_sch, mcu.kicad_sch, power.kicad_sch]
2024-04-06 updated BOM save for passives
    [gkos_pebble_BOM.xlsx]
2025-05-22 added arduino (PIO) firmware project
